rstuerm/NMRSpectrometer/NMRSpectrometerSimulation/PolarizationCoil.pdf

0 | 2 | 4 | 6 | 8 | 10

### r (mm)

-4

-2

0

2

¢

## Bz (¹

T)

Bz; ave = 1.22 mT

z = 0.0 mm
z = 5.0 mm
z = 10.0 mm
