rstuerm/NMRSpectrometer/NMRSpectrometerSimulation/PolarizationCoil_Shim.pdf

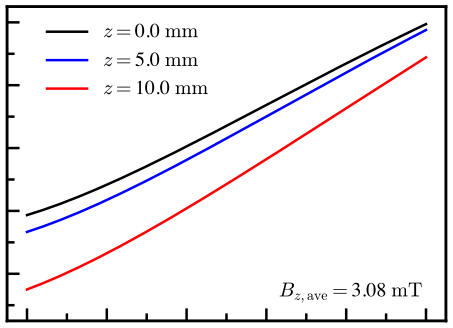
[picture p1: figure]
Bz; ave = 3.08 mT

0 | 2 | 4 | 6 | 8 | 10

### r (mm)

-6

-4

-2

0

2

¢

## Bz (¹

T)
