rstuerm/NMRSpectrometer/NMRSpectrometerSimulation/RFCoil_Helmholtz.pdf

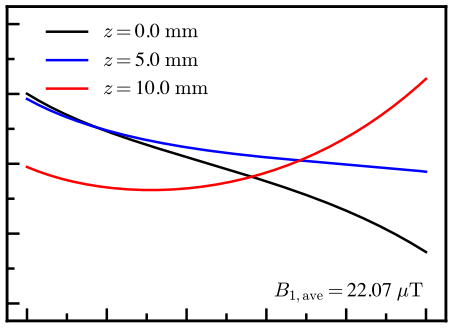
[picture p2: figure]
B1; ave = 22.07 ¹T

0 | 2 | 4 | 6 | 8 | 10

### r (mm)

-1.0

-0.5

0.0

0.5

1.0

¢

B1 (¹

T)
