rstuerm/NMRSpectrometer/NMRSpectrometerSimulation/RFCoil_Solenoid.pdf

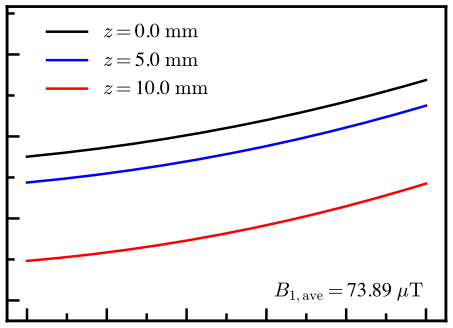
[picture p3: figure]
B1; ave = 73.89 ¹T

0 | 2 | 4 | 6 | 8 | 10

### r (mm)

-3.0

-1.5

0.0

1.5

¢

B1 (¹

T)
