rstuerm/NMRSpectrometer/HardwareCharacterization/ReceiveCircuitry/Stage1.csv

# | Frequency (Hz) | Amplitude (Vpp) | Gain (dB) | Phase ()
1 | 5000.0 | 0.1000 | 36.65 | -1.32
2 | 5175.7 | 0.1000 | 36.64 | -1.36
3 | 5357.6 | 0.1000 | 36.65 | -1.37
4 | 5545.9 | 0.1000 | 36.64 | -1.51
5 | 5740.8 | 0.1000 | 36.63 | -1.53
6 | 5942.5 | 0.1000 | 36.64 | -1.55
7 | 6151.3 | 0.1000 | 36.64 | -1.60
8 | 6367.5 | 0.1000 | 36.66 | -1.60
9 | 6591.3 | 0.1000 | 36.63 | -1.70
10 | 6822.9 | 0.1000 | 36.64 | -1.72
11 | 7062.7 | 0.1000 | 36.66 | -1.83
12 | 7310.9 | 0.1000 | 36.64 | -1.98
13 | 7567.8 | 0.1000 | 36.65 | -2.00
14 | 7833.8 | 0.1000 | 36.64 | -2.00
15 | 8109.1 | 0.1000 | 36.63 | -2.16
16 | 8394.0 | 0.1000 | 36.65 | -2.22
17 | 8689.0 | 0.1000 | 36.66 | -2.30
18 | 8994.4 | 0.1000 | 36.64 | -2.34
19 | 9310.4 | 0.1000 | 36.64 | -2.47
20 | 9637.6 | 0.1000 | 36.65 | -2.54
21 | 9976.3 | 0.1000 | 36.63 | -2.64
22 | 10326.9 | 0.1000 | 36.65 | -2.75
23 | 10689.8 | 0.1000 | 36.63 | -2.77
24 | 11065.5 | 0.1000 | 36.64 | -2.95
25 | 11454.3 | 0.1000 | 36.63 | -2.98
26 | 11856.9 | 0.1000 | 36.64 | -3.15
27 | 12273.5 | 0.1000 | 36.64 | -3.21
28 | 12704.9 | 0.1000 | 36.64 | -3.30
29 | 13151.3 | 0.1000 | 36.64 | -3.44
30 | 13613.5 | 0.1000 | 36.64 | -3.60
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
