rstuerm/NMRSpectrometer/HardwareCharacterization/ReceiveCircuitry/Stage2.csv

# | Frequency (Hz) | Amplitude (Vpp) | Gain (dB) | Phase ()
1 | 5000.0 | 0.0030 | 32.75 | 165.94
2 | 5175.7 | 0.0030 | 33.56 | 164.06
3 | 5357.6 | 0.0030 | 34.01 | 162.98
4 | 5545.9 | 0.0030 | 34.68 | 163.56
5 | 5740.8 | 0.0030 | 35.28 | 160.74
6 | 5942.5 | 0.0030 | 35.66 | 160.79
7 | 6151.3 | 0.0030 | 36.19 | 159.12
8 | 6367.5 | 0.0030 | 36.52 | 157.61
9 | 6591.3 | 0.0030 | 37.77 | 157.23
10 | 6822.9 | 0.0030 | 37.97 | 156.81
11 | 7062.7 | 0.0030 | 38.78 | 158.22
12 | 7310.9 | 0.0030 | 39.27 | 158.28
13 | 7567.8 | 0.0030 | 39.61 | 156.50
14 | 7833.8 | 0.0030 | 40.56 | 154.46
15 | 8109.1 | 0.0030 | 40.99 | 156.88
16 | 8394.0 | 0.0030 | 41.69 | 153.73
17 | 8689.0 | 0.0030 | 42.11 | 152.65
18 | 8994.4 | 0.0030 | 42.79 | 151.47
19 | 9310.4 | 0.0030 | 42.92 | 150.80
20 | 9637.6 | 0.0030 | 43.91 | 149.08
21 | 9976.3 | 0.0030 | 44.48 | 149.20
22 | 10326.9 | 0.0030 | 45.05 | 148.48
23 | 10689.8 | 0.0030 | 45.46 | 147.74
24 | 11065.5 | 0.0030 | 46.11 | 147.01
25 | 11454.3 | 0.0030 | 46.61 | 144.38
26 | 11856.9 | 0.0030 | 47.29 | 145.48
27 | 12273.5 | 0.0030 | 47.84 | 143.93
28 | 12704.9 | 0.0030 | 48.45 | 142.68
29 | 13151.3 | 0.0030 | 48.79 | 139.87
30 | 13613.5 | 0.0030 | 49.22 | 137.70
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
