rstuerm/NMRSpectrometer/HardwareCharacterization/ReceiveCircuitry/Stage1.png

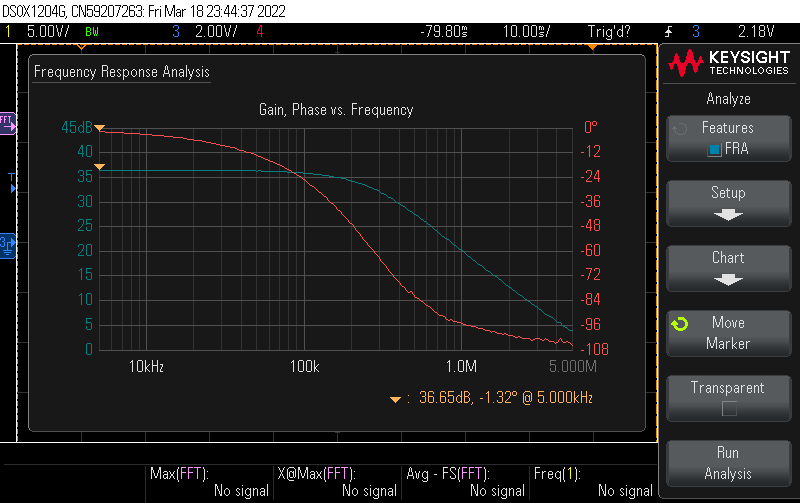
HardwareCharacterization/ReceiveCircuitry/Stage1.png
