rstuerm/NMRSpectrometer/HardwareCharacterization/ReceiveCircuitry/Stage2.png

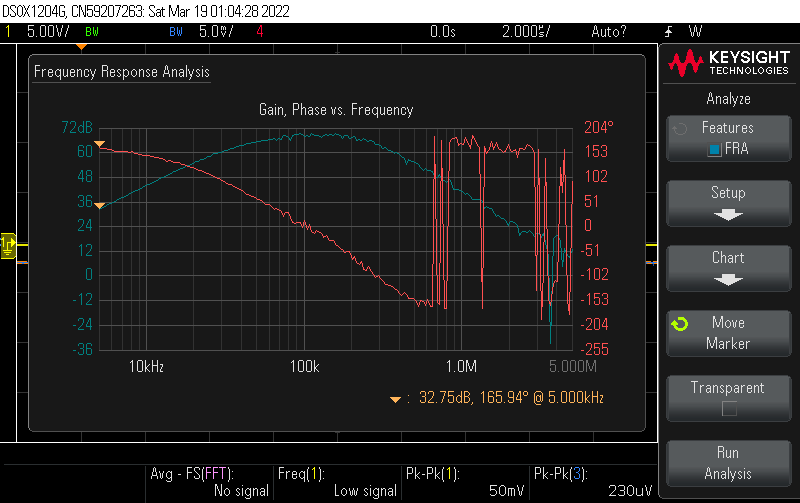
HardwareCharacterization/ReceiveCircuitry/Stage2.png
