rstuerm/NMRSpectrometer/ElectronicsSchematics/NMRSpectrometer.pdf

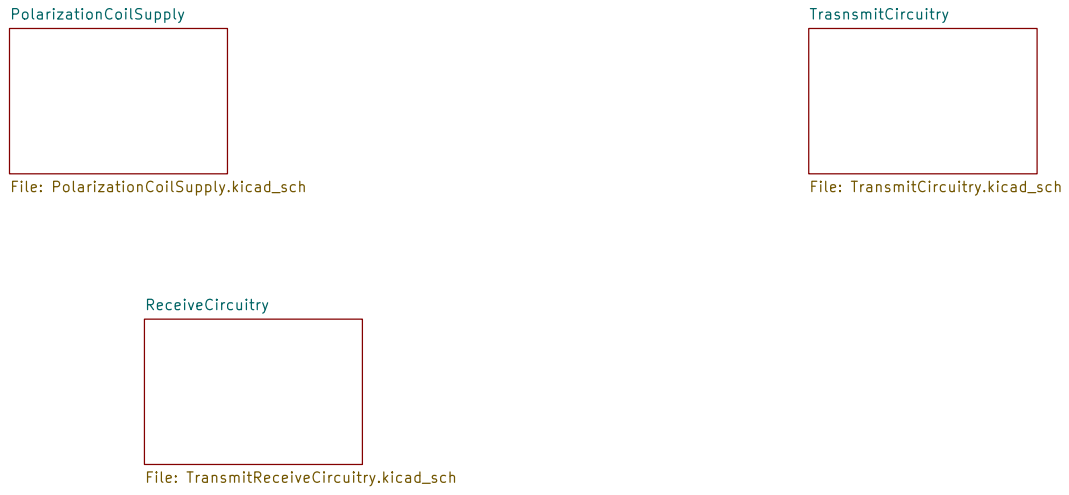
[picture p8: page 1]

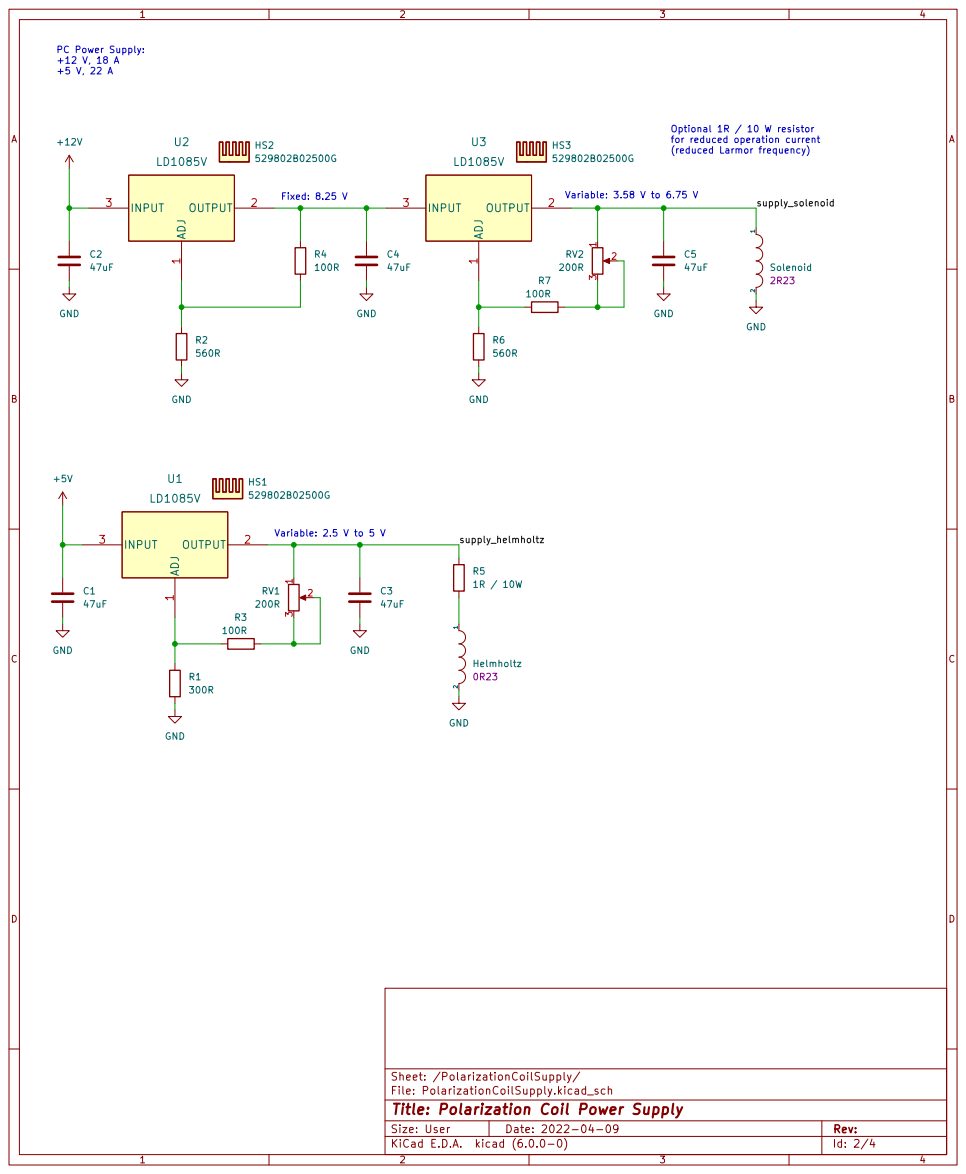
[picture p9: page 2]

for reduced operation current

Sheet: /PolarizationCoilSupply/
File: PolarizationCoilSupply.kicad_sch
Id: 2/4 Title: Polarization Coil Power Supply

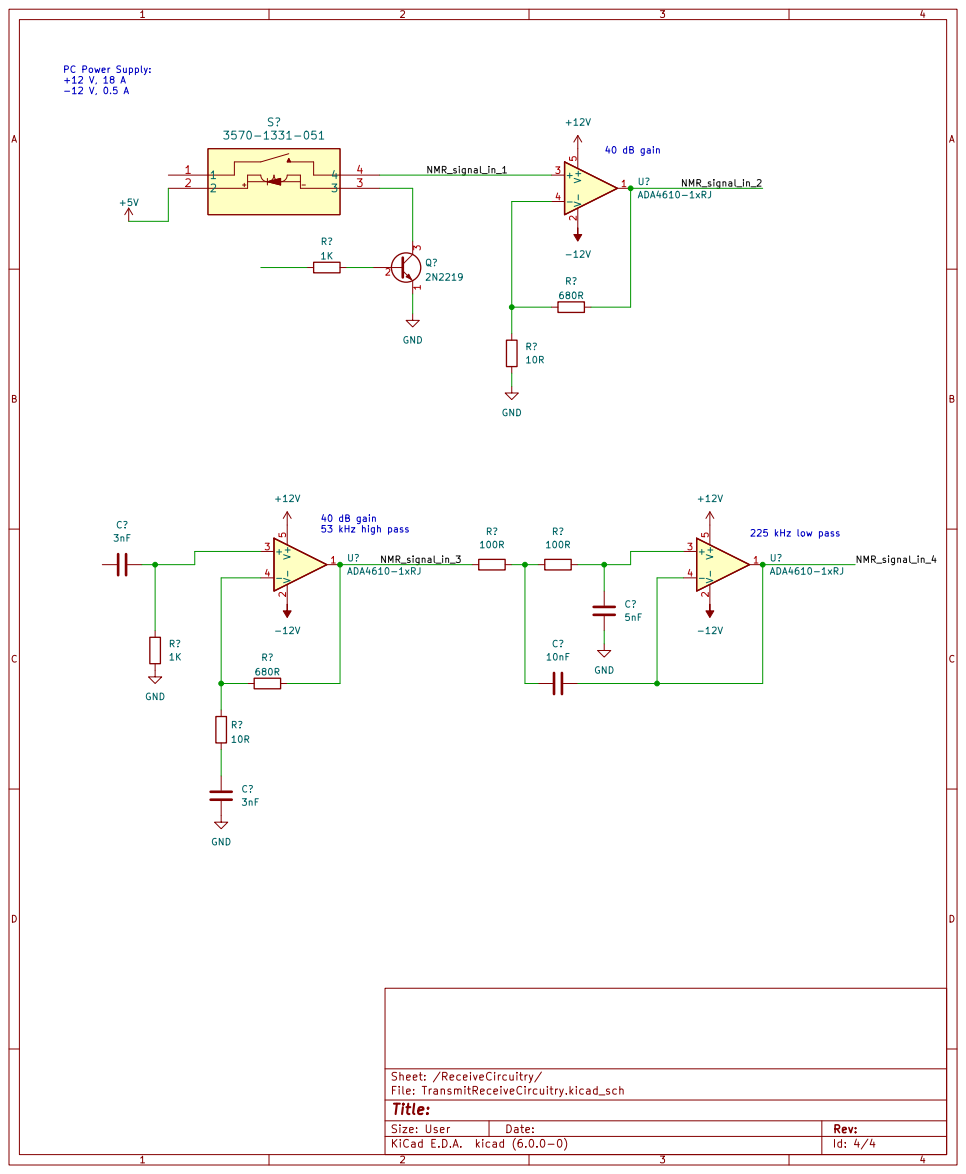
[picture p10: page 3]

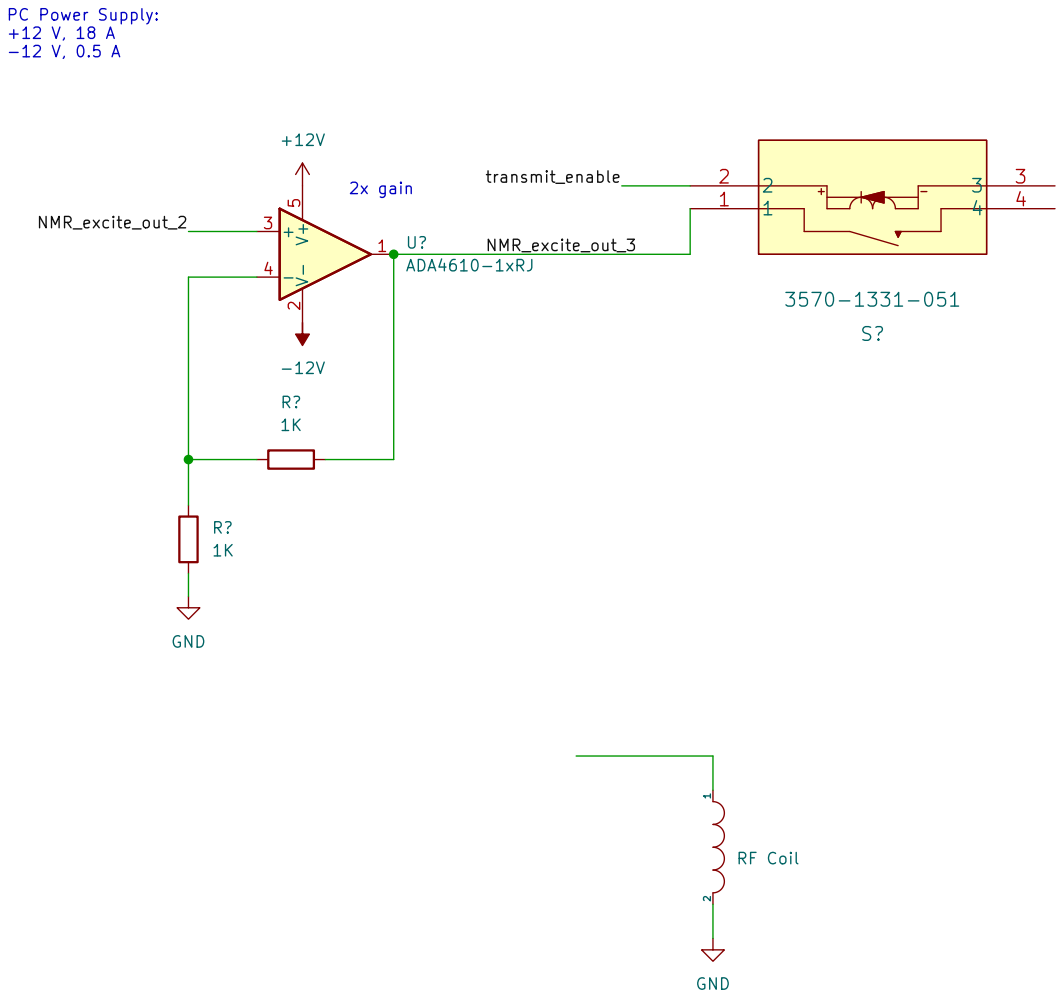
[picture p11: page 4]
