rstuerm/NMRSpectrometer/NMRSpectrometerSimulation/ReceiveSignal_FFT.pdf

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

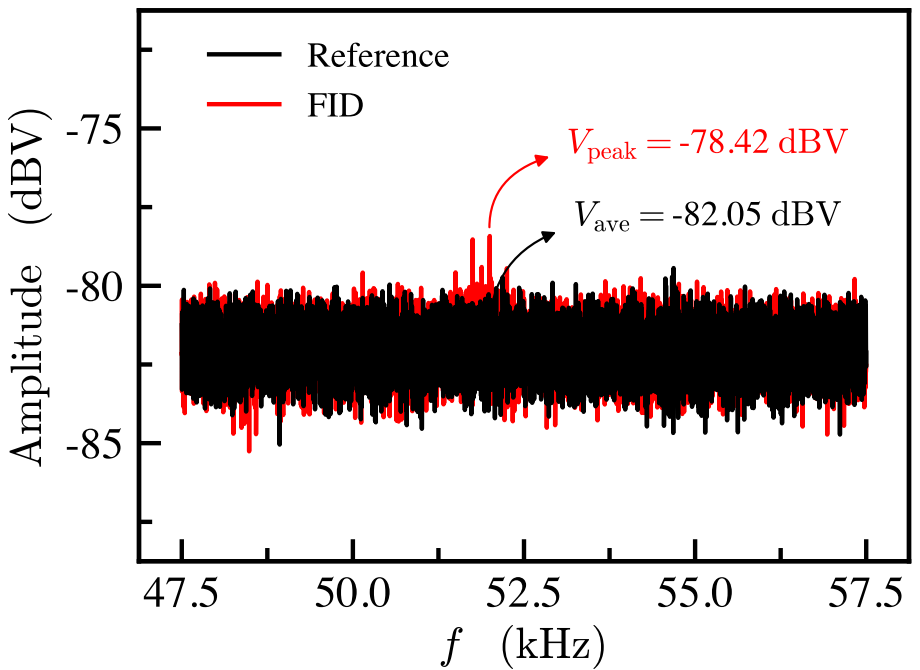
[picture p14: page 1]
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
