rstuerm/NMRSpectrometer/RecieveCircuitrySimulation/ReceiveCircuitry.asc

C1: cap; 3.3n
C2: cap; 3.3n
C3: cap; 1n
C5: cap; 2.2n
R1: res; 10
R2: res; 680
R3: res; 10
R4: res; 680
R5: res; 1k
R6: res; 68k
R7: res; 1k
R8: res; 1k
R12: res; 100
R13: res; 100
U1: ADA4610
U2: ADA4610
U3: ADA4610
V1: voltage; SINE(0 0.16u 128k); AC 1
V2: voltage; SINE(0 0.16u 250k); AC 1
V+: voltage; 12
V-: voltage; -12
Named nets: 0, +12V, -12V, v3, RF_Coil, v1, v2, v0
.tran 1u 100u 0
.ac dec 200 5Meg 5k
40.3 dB gain
40.3 dB gain, two-pole high-pass
f = 1/(2*pi*R*C)
Unitary gain, two-pole low-pass
f = \\sqrt{2}/(4*\\pi*R*C)
(Smaller capatiance)
