rstuerm/NMRSpectrometer/ElectronicsSchematics/PolarizationCoilSupply.kicad_sch

## KiCad design ElectronicsSchematics/PolarizationCoilSupply.kicad_sch (2022-12-18)

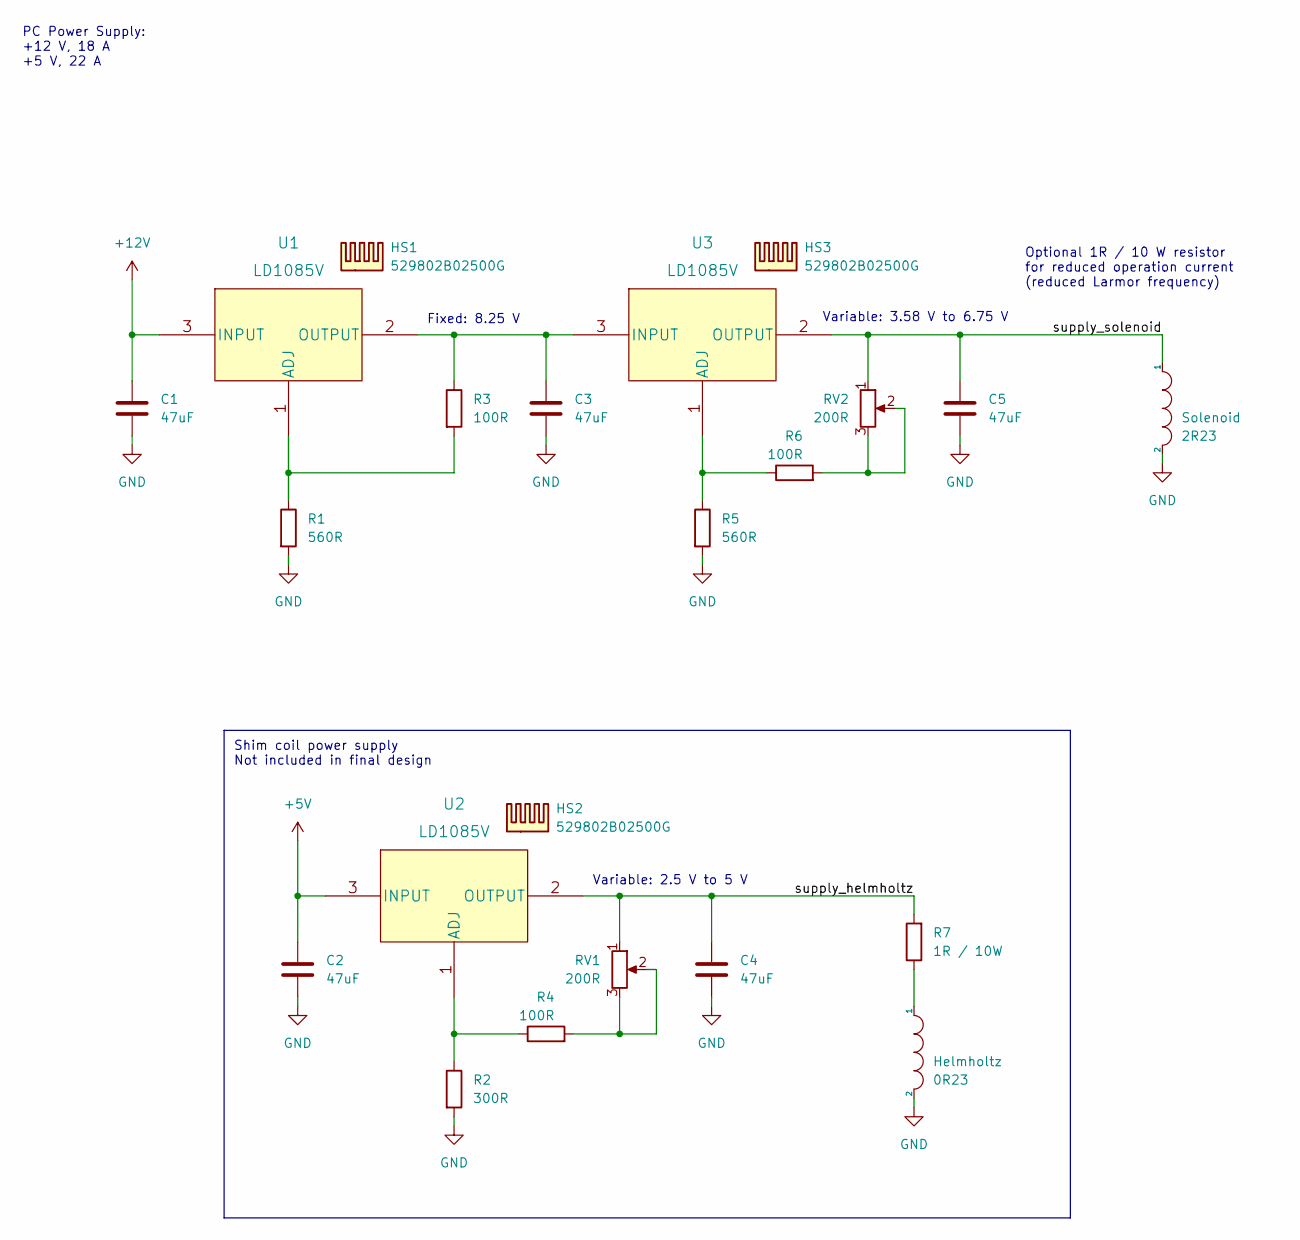
[picture p19: schematic PolarizationCoilSupply.kicad_sch]

Parts:
C1, C2, C3, C4, C5: 47uF
HS1, HS2, HS3: 529802B02500G
L1: Helmholtz
L2: Solenoid
R1, R5: 560R
R2: 300R
R3, R4, R6: 100R
R7: 1R / 10W
RV1, RV2: 200R
U1, U2, U3: LD1085V; TO-220FP_STM

Connections:
+5V: C2.1, U2.3 (INPUT)
+12V: C1.1, U1.3 (INPUT)
GND: C1.2, C2.2, C3.2, C4.2, C5.2, L1.2, L2.2, R1.2, R2.2, R5.2
unnamed: C3.1, R3.1, U1.2 (OUTPUT), U3.3 (INPUT)
unnamed: L1.1, R7.1
unnamed: R1.1, R3.2, U1.1 (ADJ)
unnamed: R2.1, R4.1, U2.1 (ADJ)
unnamed: R4.2, RV1.2, RV1.3
unnamed: R5.1, R6.1, U3.1 (ADJ)
unnamed: R6.2, RV2.2, RV2.3
supply_helmholtz: C4.1, R7.2, RV1.1, U2.2 (OUTPUT)
supply_solenoid: C5.1, L2.1, RV2.1, U3.2 (OUTPUT)

Notes on the sheet:
Shim coil power supply Not included in final design
Variable: 3.58 V to 6.75 V
PC Power Supply: +12 V, 18 A +5 V, 22 A
Variable: 2.5 V to 5 V
Fixed: 8.25 V
Optional 1R / 10 W resistor for reduced operation current (reduced Larmor frequency)
