rstuerm/NMRSpectrometer/ElectronicsSchematics/ReceiveCircuitry.kicad_sch

## KiCad design ElectronicsSchematics/ReceiveCircuitry.kicad_sch (2022-12-18)

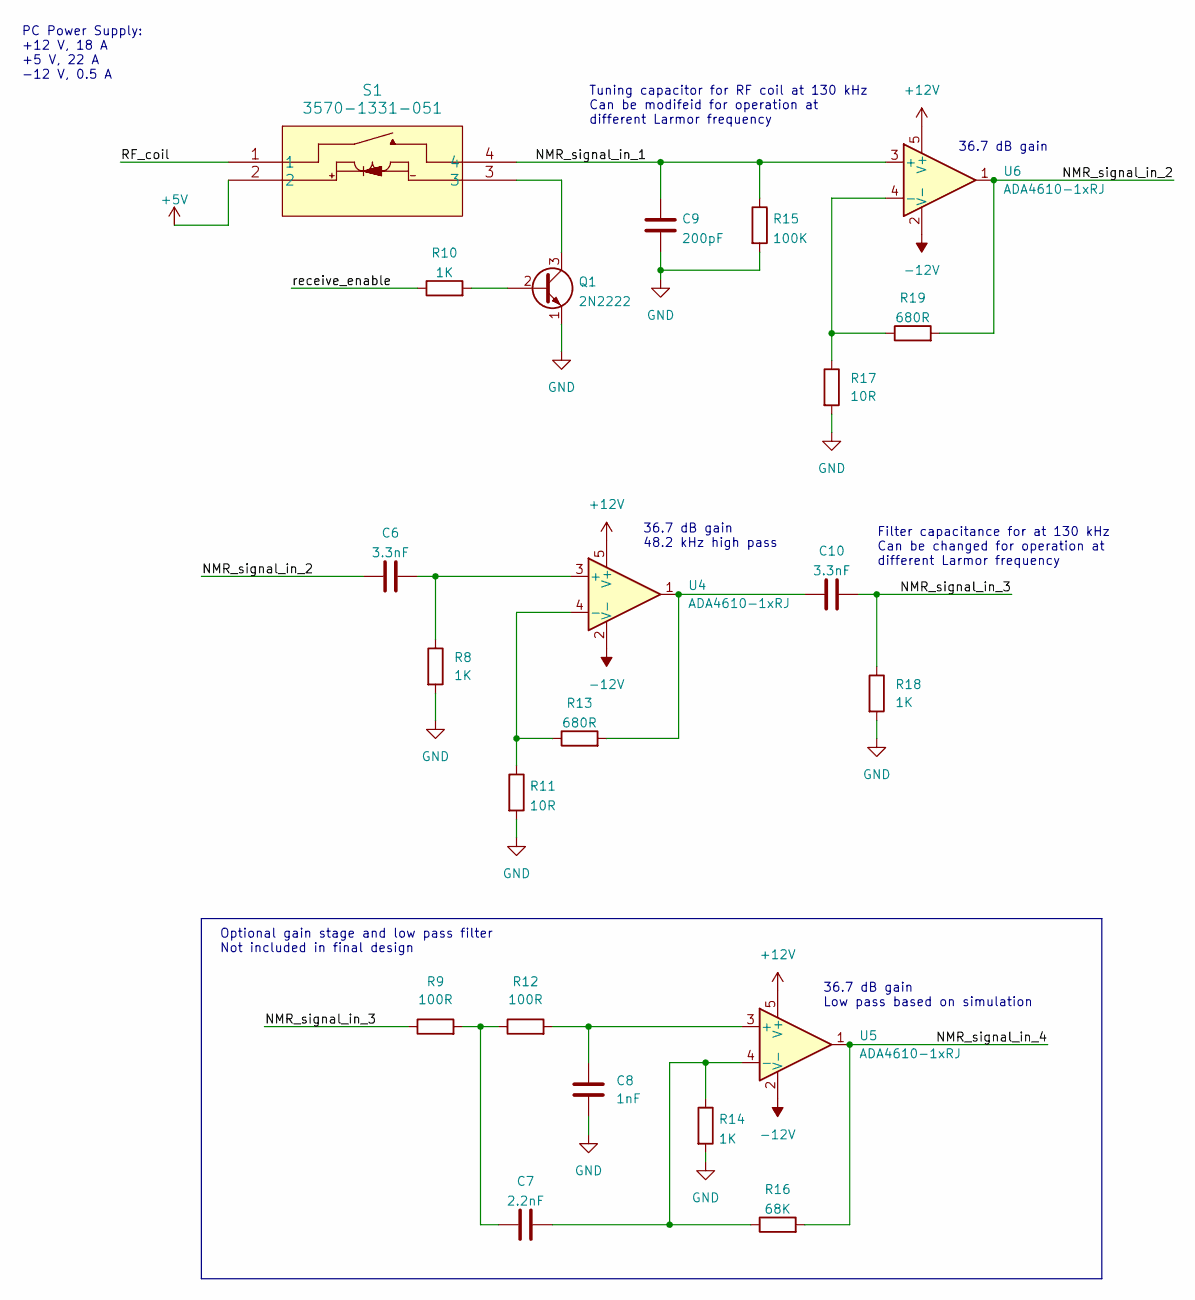
[picture p20: schematic ReceiveCircuitry.kicad_sch]

Parts:
C6, C10: 3.3nF
C7: 2.2nF
C8: 1nF
C9: 200pF
Q1: 2N2222; TO-39-3
R8, R10, R14, R18: 1K
R9, R12: 100R
R11, R17: 10R
R13, R19: 680R
R15: 100K
R16: 68K
S1: 3570-1331-051; SIP_3570-1331_COM
U4, U5, U6: ADA4610-1xRJ; SOT-23-5

Connections:
+5V: S1.2
+12V: U4.5 (V+), U5.5 (V+), U6.5 (V+)
-12V: U4.2 (V-), U5.2 (V-), U6.2 (V-)
GND: C8.1, C9.1, Q1.1 (E), R8.2, R11.2, R14.2, R15.2, R17.2, R18.2
NMR_signal_in_1: C9.2, R15.1, S1.4, U6.3 (+)
NMR_signal_in_2: C6.1, R19.2, U6.1
NMR_signal_in_3: C10.2, R9.1, R18.1
NMR_signal_in_4: R16.2, U5.1
unnamed: C6.2, R8.1, U4.3 (+)
unnamed: C7.1, R14.1, R16.1, U5.4 (-)
unnamed: C7.2, R9.2, R12.1
unnamed: C8.2, R12.2, U5.3 (+)
unnamed: C10.1, R13.2, U4.1
unnamed: Q1.2 (B), R10.2
unnamed: Q1.3 (C), S1.3
unnamed: R11.1, R13.1, U4.4 (-)
unnamed: R17.1, R19.1, U6.4 (-)
RF_coil: S1.1
receive_enable: R10.1

Notes on the sheet:
PC Power Supply: +12 V, 18 A +5 V, 22 A -12 V, 0.5 A
36.7 dB gain 48.2 kHz high pass
Tuning capacitor for RF coil at 130 kHz Can be modifeid for operation at different Larmor frequency
36.7 dB gain
Optional gain stage and low pass filter Not included in final design
Filter capacitance for at 130 kHz Can be changed for operation at different Larmor frequency
36.7 dB gain Low pass based on simulation
