rstuerm/NMRSpectrometer/ElectronicsSchematics/TransmitCircuitry.kicad_sch

## KiCad design ElectronicsSchematics/TransmitCircuitry.kicad_sch (2022-12-18)

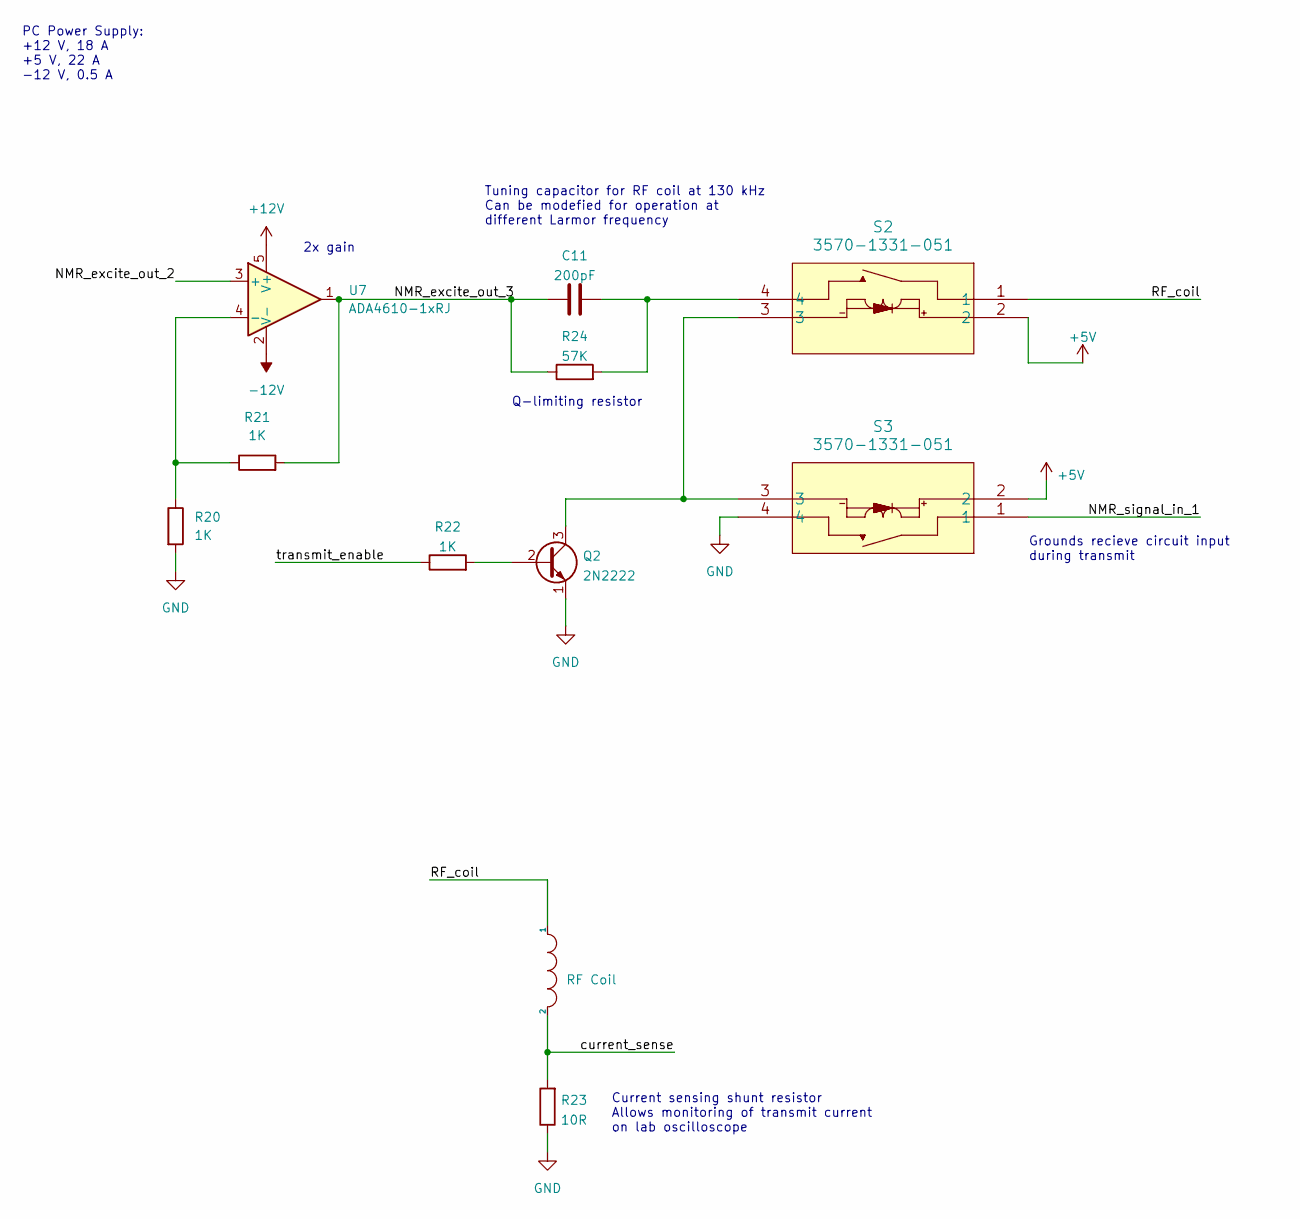
[picture p21: schematic TransmitCircuitry.kicad_sch]

Parts:
C11: 200pF
L3: RF Coil
Q2: 2N2222; TO-39-3
R20, R21, R22: 1K
R23: 10R
R24: 57K
S2, S3: 3570-1331-051; SIP_3570-1331_COM
U7: ADA4610-1xRJ; SOT-23-5

Connections:
+5V: S2.2, S3.2
+12V: U7.5 (V+)
-12V: U7.2 (V-)
GND: Q2.1 (E), R20.2, R23.1, S3.4
NMR_excite_out_2: U7.3 (+)
NMR_excite_out_3: C11.1, R21.2, R24.1, U7.1
NMR_signal_in_1: S3.1
unnamed: C11.2, R24.2, S2.4
unnamed: Q2.2 (B), R22.2
unnamed: Q2.3 (C), S2.3, S3.3
unnamed: R20.1, R21.1, U7.4 (-)
RF_coil: L3.1, S2.1
current_sense: L3.2, R23.2
transmit_enable: R22.1

Notes on the sheet:
Tuning capacitor for RF coil at 130 kHz Can be modefied for operation at different Larmor frequency
Grounds recieve circuit input during transmit
2x gain
PC Power Supply: +12 V, 18 A +5 V, 22 A -12 V, 0.5 A
Current sensing shunt resistor Allows monitoring of transmit current on lab oscilloscope
Q-limiting resistor
