rstuerm/NMRSpectrometer/(commit log)

2022-03-28 restructure files, add PWM trigger
2022-04-03 Workoaround AD2 missed capture, average after FFT, small arduino improvemnts
    [Arduino_Control.ino, Parameters.h, main.cpp]
2022-04-12 Update simulations
    [transmit.csv]
2022-12-18 Update NMR Spectrometer files
    [NMRSpectrometer.kicad_pcb, NMRSpectrometer.kicad_sch, PolarizationCoilSupply.kicad_sch, ReceiveCircuitry.kicad_sch, Stage1.csv, Stage2.csv, TransmitCircuitry.kicad_sch, TransmitPulse_Helmholtz.csv]
